yusuf0205/LiFi-BFSK-VLC/hardware/sim/link_budget.md

Branch-A noise bandwidth B_eq = 11.3 kHz, peak transimpedance = 9.50 MOhm, at 10k/15k = 8.03/8.06 MOhm
| d (m) | angle | P_rx peak (uW) | I_on (nA) | I_sig fund. rms (nA) | XR2211 in (mV rms) | ambient (uA) | noise in B_eq (pA rms) | SNR (dB) | Eb/N0 @4.8k (dB) | BER ncFSK @4.8k | BER @10k |
|---|---|---|---|---|---|---|---|---|---|---|---|
| 0.5 | 0 deg | 2.39 | 716 | 322 | 1.7e+03 (clips, OK for FSK) | 10 | 279 | 61.3 | 65.0 | <1e-12 | <1e-12 |
| 1 | 0 deg | 0.597 | 179 | 80.6 | 647 | 2 | 137 | 55.4 | 59.1 | <1e-12 | <1e-12 |
| 1 | 0 deg | 0.597 | 179 | 80.6 | 647 | 10 | 277 | 49.3 | 53.0 | <1e-12 | <1e-12 |
| 1 | 0 deg | 0.597 | 179 | 80.6 | 647 | 50 | 605 | 42.5 | 46.2 | <1e-12 | <1e-12 |
| 2 | 0 deg | 0.149 | 44.8 | 20.2 | 162 | 10 | 277 | 37.3 | 41.0 | <1e-12 | <1e-12 |
| 3 | 0 deg | 0.0663 | 19.9 | 8.96 | 71.9 | 2 | 136 | 36.4 | 40.1 | <1e-12 | <1e-12 |
| 3 | 0 deg | 0.0663 | 19.9 | 8.96 | 71.9 | 10 | 276 | 30.2 | 33.9 | <1e-12 | <1e-12 |
| 3 | 0 deg | 0.0663 | 19.9 | 8.96 | 71.9 | 50 | 605 | 23.4 | 27.1 | <1e-12 | <1e-12 |
| 3 | 30 deg | 0.0497 | 14.9 | 6.72 | 53.9 | 10 | 276 | 27.7 | 31.4 | <1e-12 | <1e-12 |
| 3 +15deg TX lens | 0 deg | 1.99 | 597 | 269 | 1.7e+03 (clips, OK for FSK) | 10 | 278 | 59.7 | 63.4 | <1e-12 | <1e-12 |
max range @10 kbps, ambient 2 uA, bare LED: 6.2 m
max range @10 kbps, ambient 2 uA, 15deg TX lens: 34.1 m
max range @10 kbps, ambient 10 uA, bare LED: 4.4 m
max range @10 kbps, ambient 10 uA, 15deg TX lens: 23.9 m
max range @10 kbps, ambient 50 uA, bare LED: 3.0 m
max range @10 kbps, ambient 50 uA, 15deg TX lens: 16.2 m
