yusuf0205/LiFi-BFSK-VLC/hardware/rx_ac_response.png

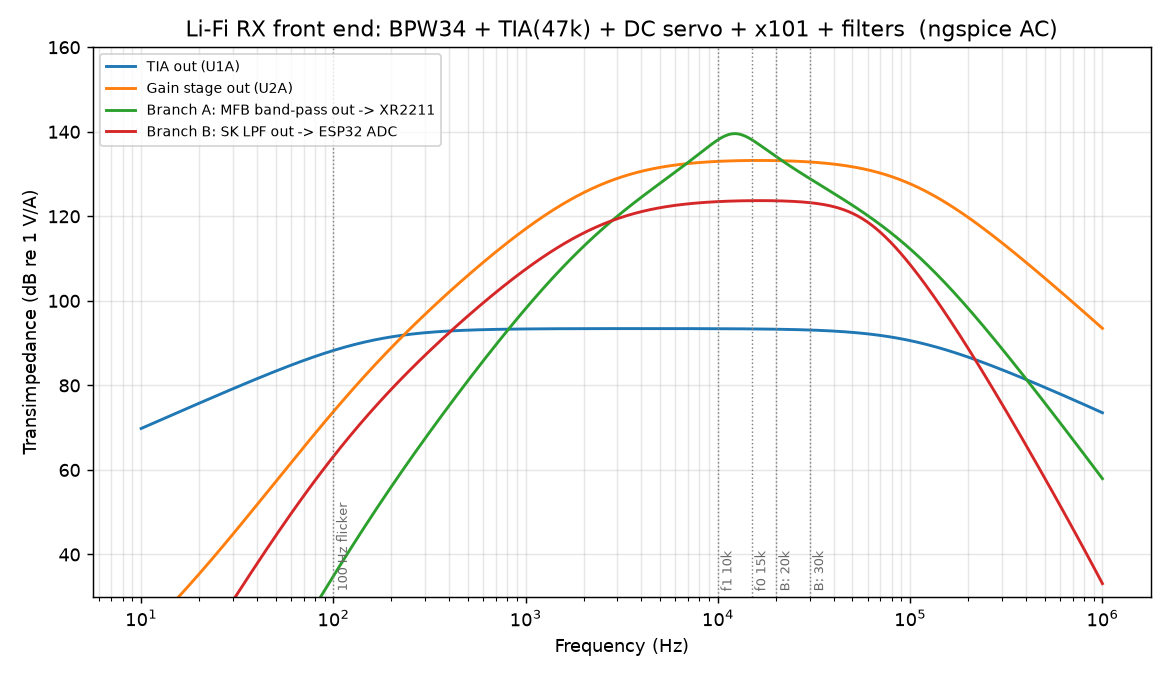
hardware/rx_ac_response.png
