yusuf0205/LiFi-BFSK-VLC/hardware/rx_noise.png

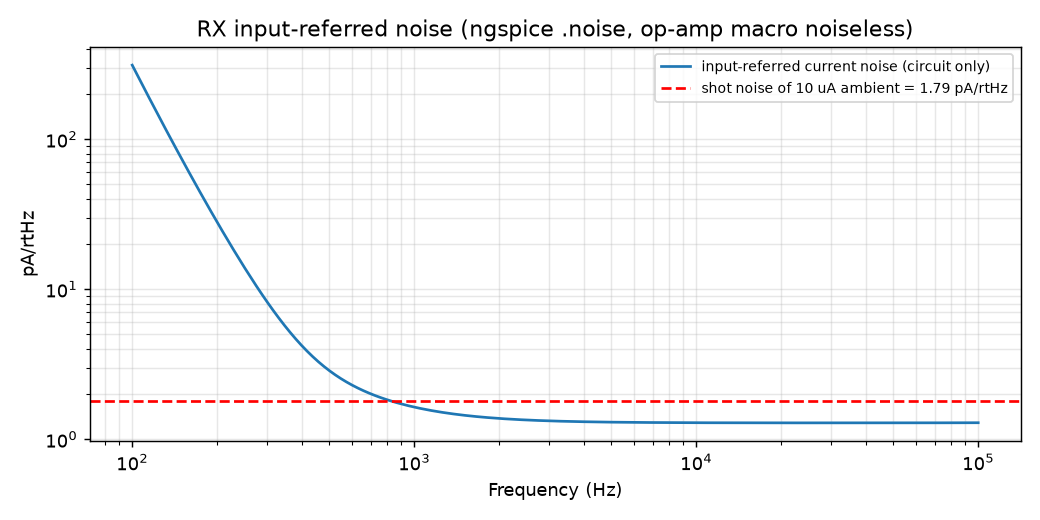
hardware/rx_noise.png
