yusuf0205/LiFi-BFSK-VLC/hardware/tx_transient.png

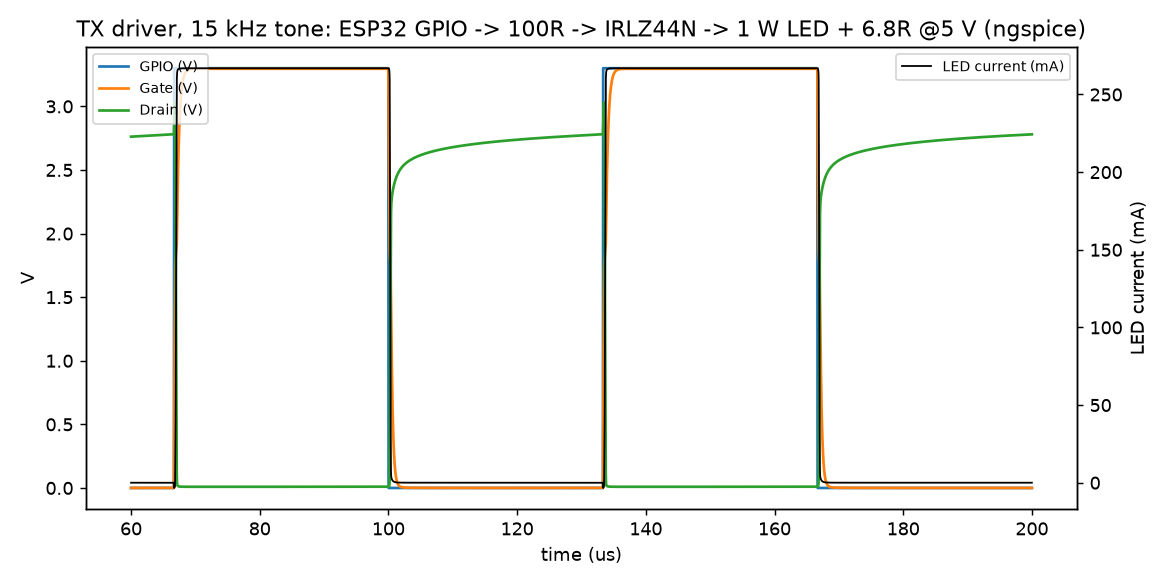
hardware/tx_transient.png
