yusuf0205/LiFi-BFSK-VLC/sim/out/ber_curve.png

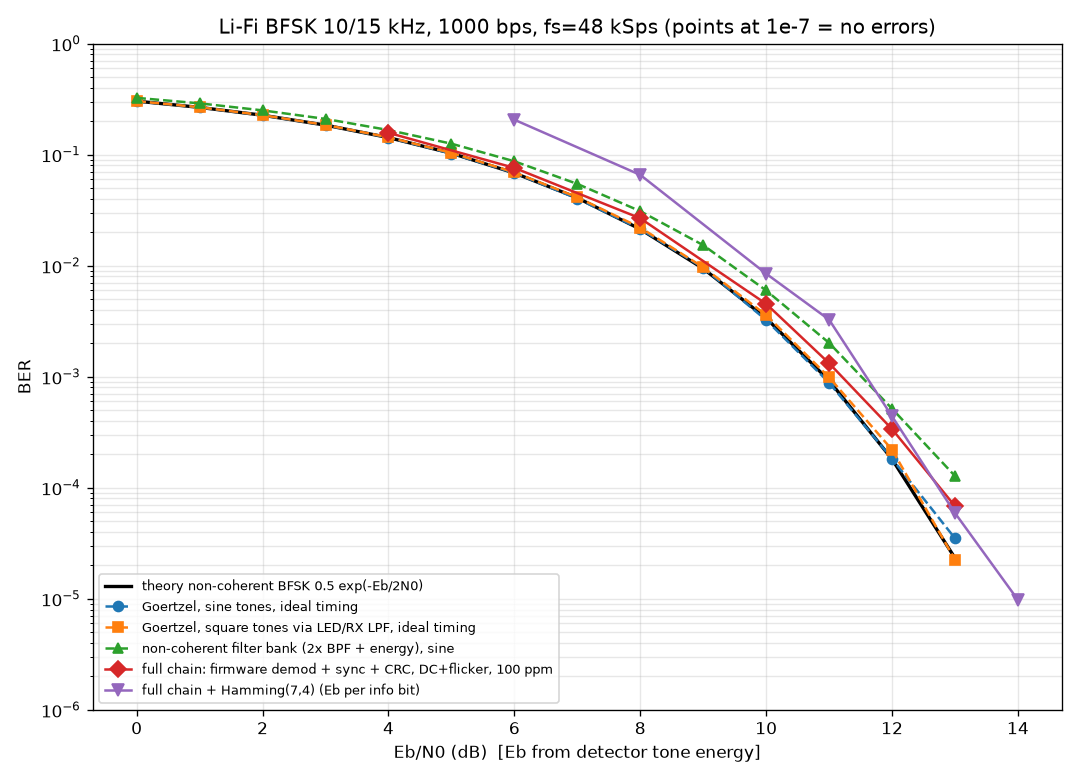
sim/out/ber_curve.png
