yusuf0205/LiFi-BFSK-VLC/sim/out/ber_distance.png

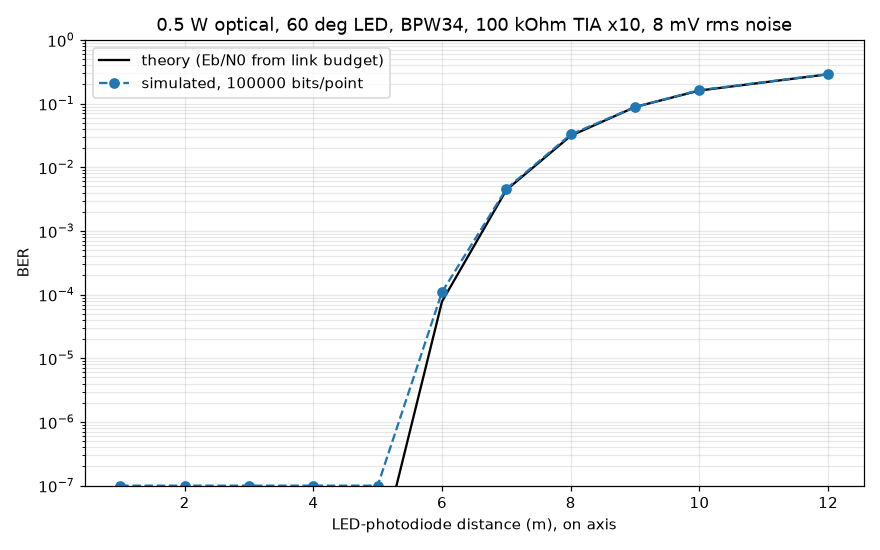
sim/out/ber_distance.png
