yusuf0205/LiFi-BFSK-VLC/sim/out/spectrum.png

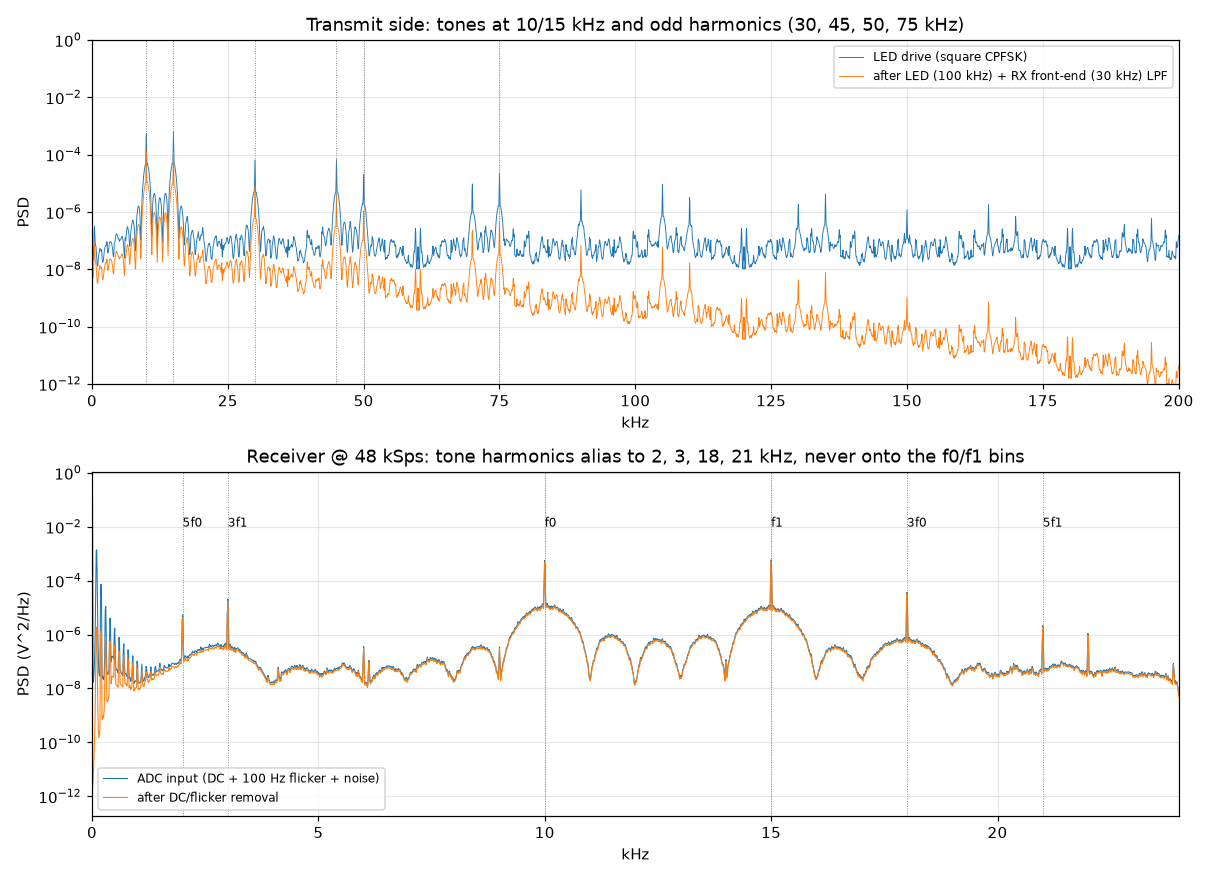
sim/out/spectrum.png
