yusuf0205/LiFi-BFSK-VLC/sim/out/waveforms.png

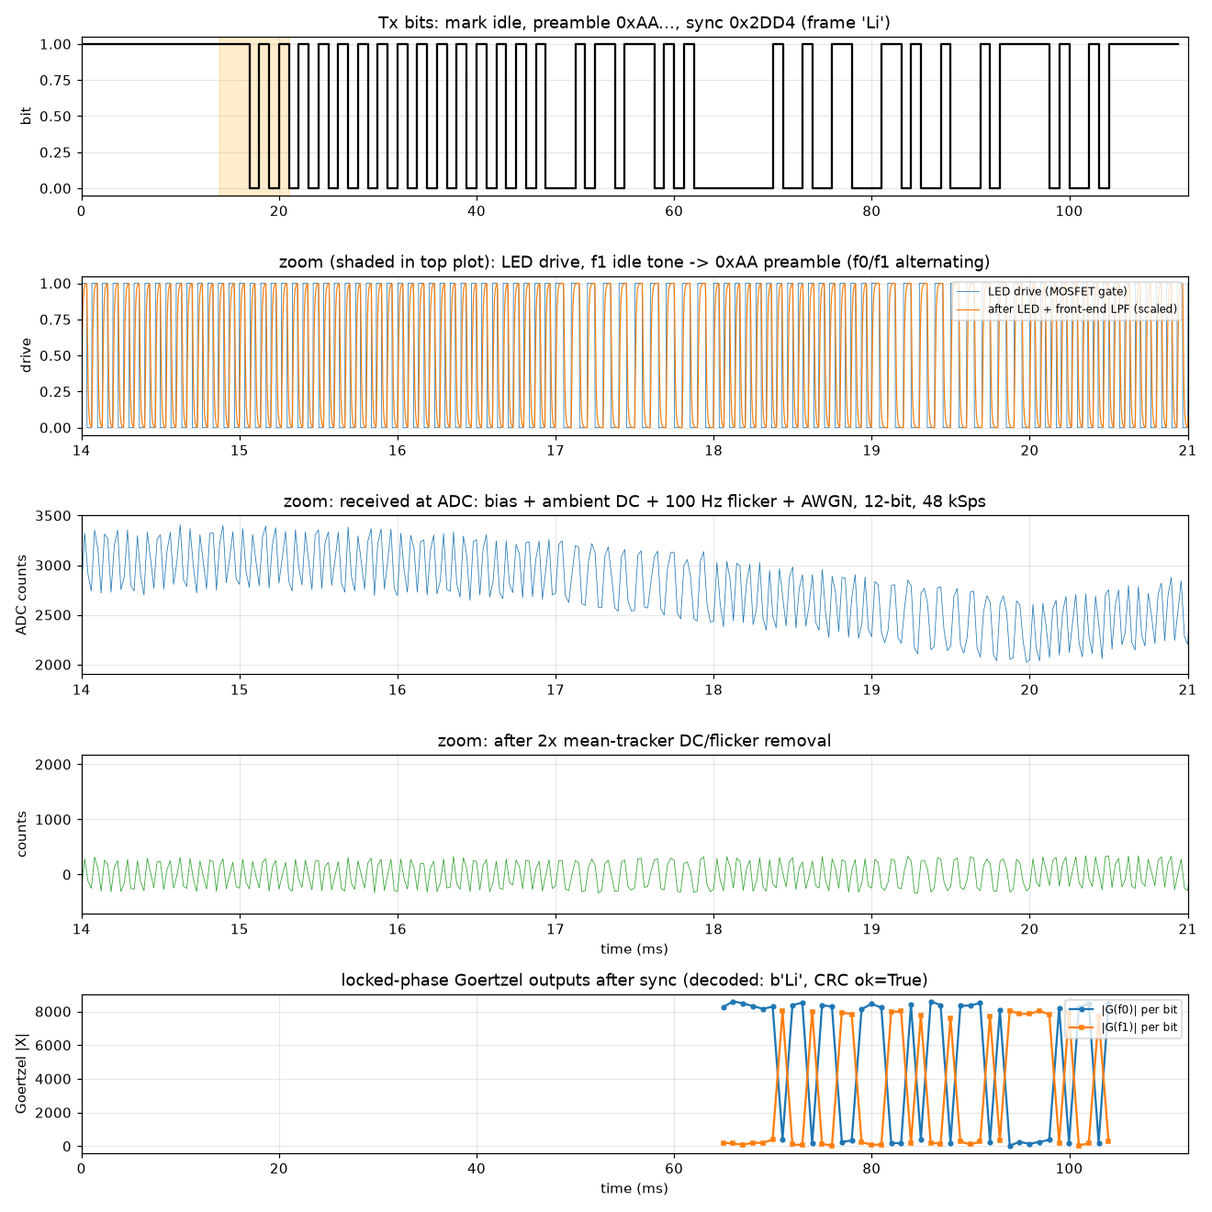
sim/out/waveforms.png
